embedded-sergey/innoproject/(list of files, drawings)

Other design files:
diagrams/component_digram.ms14
