embedded-sergey/innoproject/sensors/HMP60_GMP252/HMP60_GMP252.ino

#include <Controllino.h> /* Usage of CONTROLLINO library allows you to use CONTROLLINO_xx aliases in your sketch. */
#include "ModbusRtu.h" /* Usage of ModBusRtu library allows you to implement the Modbus RTU protocol in your sketch. */

// This MACRO defines Modbus master address.
// For any Modbus slave devices are reserved addresses in the range from 1 to 247.
// Important note only address 0 is reserved for a Modbus master device!

#define MasterModbusAdd 0  // Controllino Maxi
#define SlaveModbusAdd_GMP252 239 // Vaisala probe GMP252
#define SlaveModbusAdd_HMP60  240 // Vaisala probe HMP60


// This MACRO defines number of the comport that is used for RS 485 interface.
// For MAXI and MEGA RS485 is reserved UART Serial3.
#define RS485Serial 3

// The object ControllinoModbuSlave of the class Modbus is initialized with three parameters.
// The first parametr specifies the address of the Modbus slave device.
// The second parameter specifies type of the interface used for communication between devices - in this sketch - RS485.
// The third parameter can be any number. During the initialization of the object this parameter has no effect.
Modbus ControllinoModbusMaster(MasterModbusAdd, RS485Serial, 0);

// This uint16 array specified internal registers in the Modbus slave device.
// Each Modbus device has particular internal registers that are available for the Modbus master.
// In this example sketch internal registers are defined as follows:
// (ModbusSlaveRegisters 0 - 3 read only and ModbusSlaveRegisters 4 - 7 write only from the Master perspective):
// ModbusSlaveRegisters[0] - Read an analog value from the CONTROLLINO_A0 - returns value in the range from 0 to 1023.
// ModbusSlaveRegisters[1] - Read an digital value from the CONTROLLINO_D0 - returns only the value 0 or 1.
// ModbusSlaveRegisters[2] - Read the number of incoming messages - Communication diagnostic.
// ModbusSlaveRegisters[3] - Read the number of number of outcoming messages - Communication diagnostic.
// ModbusSlaveRegisters[4] - Sets the Relay output CONTROLLINO_R0 - only the value 0 or 1 is accepted.
// ModbusSlaveRegisters[5] - Sets the Relay output CONTROLLINO_R1 - only the value 0 or 1 is accepted.
// ModbusSlaveRegisters[6] - Sets the Relay output CONTROLLINO_R2 - only the value 0 or 1 is accepted.
// ModbusSlaveRegisters[7] - Sets the Relay output CONTROLLINO_R3 - only the value 0 or 1 is accepted.
uint16_t ModbusSlaveRegisters[8];

// This is an structe which contains a query to an slave device
modbus_t ModbusQuery[2];

uint8_t myState; // machine state
uint8_t currentQuery; // pointer to message query

unsigned long WaitingTime;

void setup() {
  // initialize serial communication at 9600 bits per second:
  Serial.begin(19200);
  Serial.println("-----------------------------------------");
  Serial.println("CONTROLLINO Modbus RTU Master Test Sketch");
  Serial.println("-----------------------------------------");
  Serial.println("");
  // ModbusQuery 0: read registers
  ModbusQuery[0].u8id = SlaveModbusAdd_HMP60; // slave address
  ModbusQuery[0].u8fct = 3; // function code (this one is registers read)
  ModbusQuery[0].u16RegAdd = 0; // start address in slave
  ModbusQuery[0].u16CoilsNo = 4; // number of elements (coils or registers) to read
  ModbusQuery[0].au16reg = ModbusSlaveRegisters; // pointer to a memory array in the CONTROLLINO
  
  ModbusQuery[1].u8id = SlaveModbusAdd_GMP252; // slave address
  ModbusQuery[1].u8fct = 3; // function code (this one is registers read)
  ModbusQuery[1].u16RegAdd = 0; // start address in slave
  ModbusQuery[1].u16CoilsNo = 4; // number of elements (coils or registers) to read
  ModbusQuery[1].au16reg = ModbusSlaveRegisters+4; // pointer to a memory array in the CONTROLLINO
  
  ControllinoModbusMaster.begin(19200, SERIAL_8N2); // baud-rate at 19200, 8-bit data, 
                                                    // no parity, 2 stop bits 
  ControllinoModbusMaster.setTimeOut( 5000 ); // if there is no answer in 5000 ms, roll over
 
  WaitingTime = millis() + 1000;
  myState = 0;
  currentQuery = 0; 
}

void loop() {
  switch( myState ) {
    case 0: 
    if (millis() > WaitingTime) myState++; // wait state
    break;
    case 1: 
    //Serial.print("---- Sending query ");
    //Serial.print(currentQuery);
    //Serial.println(" -------------");
    ControllinoModbusMaster.query( ModbusQuery[currentQuery] ); // send query (only once)
    myState++;
    currentQuery++;
    if (currentQuery == 2) {
      currentQuery = 0;
    }
    break;
    case 2:
    ControllinoModbusMaster.poll(); // check incoming messages
    if (ControllinoModbusMaster.getState() == COM_IDLE){
      // response from the slave was received
      myState = 0;
      WaitingTime = millis() + 1000; 
      // debug printout   
      if (currentQuery == 0){
        // registers write was proceed
        // Serial.println("---------- WRITE RESPONSE RECEIVED ----");
        // Serial.println("");
      }
         
      if (currentQuery == 1){
        // registers read was proceed
        Serial.println("---------- READ RESPONSE RECEIVED ----");
        Serial.println("Slave device: Vaisala HMP60");
        Serial.print("Modbus address: ");
        Serial.println(SlaveModbusAdd_HMP60, DEC); 
        Serial.print("Humidity registers (lsb, msb): "); // lsb and msb - least and most significant bits
        Serial.print(ModbusSlaveRegisters[0], HEX);
        Serial.print(", ");
        Serial.println(ModbusSlaveRegisters[1], HEX);
        Serial.print("Temperature registers (lsb, msb): ");
        Serial.print(ModbusSlaveRegisters[2], HEX);
        Serial.print(", ");
        Serial.println(ModbusSlaveRegisters[3], HEX);
        Serial.println("");
        
        float HMP60_humidity;
        unsigned long *HMP60_humidity_uint32;
        HMP60_humidity_uint32 = (unsigned long*)&HMP60_humidity;
        *HMP60_humidity_uint32 = (unsigned long)ModbusSlaveRegisters[1]<<16 | ModbusSlaveRegisters[0]; // Float - Mid-Little Endian CDAB
        Serial.print("Air humidity (%RH): ");
        Serial.println(HMP60_humidity, 2);

        float HMP60_temperature;
        unsigned long *HMP60_temperature_uint32;
        HMP60_temperature_uint32 = (unsigned long*)&HMP60_temperature;
        *HMP60_temperature_uint32 = (unsigned long)ModbusSlaveRegisters[3]<<16 | ModbusSlaveRegisters[2]; // Float - Mid-Little Endian CDAB
        Serial.print("Air temperature (°C): ");
        Serial.println(HMP60_temperature, 2);

        Serial.println("-------------------------------------");
        Serial.println("");
 
        // registers read was proceed
        Serial.println("Slave device: Vaisala GMP252");
        Serial.print("Modbus address: ");
        Serial.println(SlaveModbusAdd_GMP252, DEC); 
        Serial.print("Carbon Dioxide registers (lsb, msb): "); // lsb and msb - least and most significant bits
        Serial.print(ModbusSlaveRegisters[4], HEX);
        Serial.print(", ");
        Serial.println(ModbusSlaveRegisters[5], HEX);
        Serial.print("Temperature registers (lsb, msb): ");
        Serial.print(ModbusSlaveRegisters[6], HEX);
        Serial.print(", ");
        Serial.println(ModbusSlaveRegisters[7], HEX);
        Serial.println("");

        float GMP252_CO2;
        unsigned long *GMP252_CO2_uint32;
        GMP252_CO2_uint32 = (unsigned long*)&GMP252_CO2;
        *GMP252_CO2_uint32 = (unsigned long)ModbusSlaveRegisters[5]<<16 | ModbusSlaveRegisters[4]; // Float - Mid-Little Endian CDAB
        Serial.print("CO2 (ppm): ");
        Serial.println(GMP252_CO2, 2);

        float GMP252_temperature;
        unsigned long *GMP252_temperature_uint32;
        GMP252_temperature_uint32 = (unsigned long*)&GMP252_temperature;
        *GMP252_temperature_uint32 = (unsigned long)ModbusSlaveRegisters[7]<<16 | ModbusSlaveRegisters[6]; // Float - Mid-Little Endian CDAB
        Serial.print("Compensation temperature (°C): ");
        Serial.println(GMP252_temperature, 2);

        Serial.println("-------------------------------------");
        Serial.println("");
      }
    }
    break;
  }
}

// REFERENCES:
// 1. Wiring: https://www.controllino.com/knowledge-base/rs485-modbusrtu/
// 2. Example code: https://github.com/CONTROLLINO-PLC/CONTROLLINO_Library/blob/master/MAXI/DemoModbusRTUMaster/ModbusRtu.h
// 3. From uint32 to float (IEEE-754): https://forum.arduino.cc/t/combine-two-uint16_t-in-one-float/507834/17 
// 4. Hex converter: https://www.scadacore.com/tools/programming-calculators/online-hex-converter/
// 5. Vaisala HMP60: https://docs.vaisala.com/r/M211060EN-J/en-US/GUID-899F92B4-583C-404B-A4BA-0D47330C6573
