embedded-sergey/innoproject/(commit log)

2022-02-23 Save data from RuuviTag
    Work well right now with 1 sensor (the pressure doesn't work)
2022-03-18 Add two files describing pH sensor testing
    The DFRobot_pH_v1.ino has been used for getting data with 1 sec
    interval. There is no temperature compensation. The file data_log.txt
    contains all the calibration information and logs.
2022-05-16 Add averaging in cm and %
    The sensor works as it was intended initially. The stability was achieved by averaging of 5 measurements (samples). Finally, the programme displays the result in percentages and centimeters. The delay is 1 second.
2022-05-30 working code
    Grove - TDS Sensor is used to determine EC value of the water, which provides the important information about the water quality. The code gives the average of 5 samples, delays are used.
2022-07-12 Add temperature compensation and clean code
    A waterproof temperature sensor code should be added later, most likely for LM35.
2022-07-20 add a water pump
    The code for a water pump was added to the initial code of the water level sensor. The pump delivers water to the main tank from the additional one.
2022-07-27 water pump
    A pump mixes the water in the main tank to provide an endless flow for sensors such as EC and pH sensors. The code has no emergency stop button, it will be added later.
2022-07-27 Add water pump
    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
2022-08-04 Add code for two water temperature sensors
2022-08-04 Create Ruuvitag Sensors RP
2022-08-27 Add the file all_together as a main one for Controllino
    The file all_together contains code combining all scripts
    written for Controllino: i.e. wired sensors, pumps, alarm, etc.
    In this commit, the file contains only pinout of the future system
    without working functional code that will be added later.
2022-08-28 Add 1-Wire methods to rapid up calculations
    The old method for DS18B20 consumed too much time, i.e.
    each sensor adds up 750 ms to one iteration. Using 1-Wire
    communication protocol, we will overcome this limitation.
    To use 1-Wire method, first identify unique addresses of
    each DS18B20 sensor using the file "DS18B20_get_address.ino".
    Then, insert the unique addresses to the file "DS18B29_one_wire"
    and run the script.
    [DS18B20_get_address.ino, DS18B20_one_wire.ino, DS18B20_simple.ino]
2022-08-28 Update the pinout map and add 1-Wire to all_together.ino
    As we do not need two digital pins for two water temperature
    sensors anymore based on 1-Wire protocol, pinout indexes for
    digital pins were shifted by one.
    The next step is to implement other sensors and create functions
    for each of them. OOP might be used as well, but later.
2022-09-01 Add the water level sensor
2022-10-08 Remove wrong files for Vaisala probes
    [HMP60.ino]
2022-10-08 Add Vaisala HMP60 via Modbus-RTU
    This code works well with the humidity sensor HMP60 by Vaisala.
    There are minimum changes from the original file located here:
    https://github.com/CONTROLLINO-PLC/CONTROLLINO_Library/blob/master
    /MAXI/DemoModbusRTUMaster/DemoModbusRTUMaster.ino
2022-10-09 Add code for Modbus protocol working with two sensors
2022-12-01 add code for LED-strip, tested, works well
2022-12-22 Add main diagram for Controllino & components
    [Main_diagram.ms14]
2023-01-03 Add I2C, UART and Modbus RTU in pinout
2023-01-17 Implement two functions with millis()
2023-01-19 Add buzzer, heater & pump dependent on water level
2023-01-25 Add and test temperature control module
    module = temperature sensor + heater
    note: the heater is on only when alarm is off
2023-01-26 Add pH and TDS sensors
    note : EC equation does not use the real temperature value yet
2023-02-22 Add code for ORP sensor (UART mode)
    The code is compatible with CONTROLLINO MAXI. Based on the official instructions for Atlas Scientific ORP.
2023-03-08 Add new clean for two GMP252 probes
2023-03-11 Finish implementing CO2 sensors, but not millis
2023-03-20 Refactor code and remove millis vars from global
2023-05-20 Add water t° and ORP to state machine, pH modified
    ORP and CO2 need adjustment (timing issues)
    [state_machine.ino]
2023-05-28 Fix ORP issue and EC formula
    [GMP252_GMP252.ino, HMP60_GMP252.ino, state_machine.ino]
2023-05-28 Add Fan and Buzzer to state machine
    [state_machine.ino]
2023-06-04 Add component diagram
    Add complete component diagram designed in Multisim software
    [component_digram.ms14]
2023-07-06 Refactor file structure
    [component_digram.ms14]
